OxfordUniRacing/TSAL_ECAD/doc/Compensation_Design.png

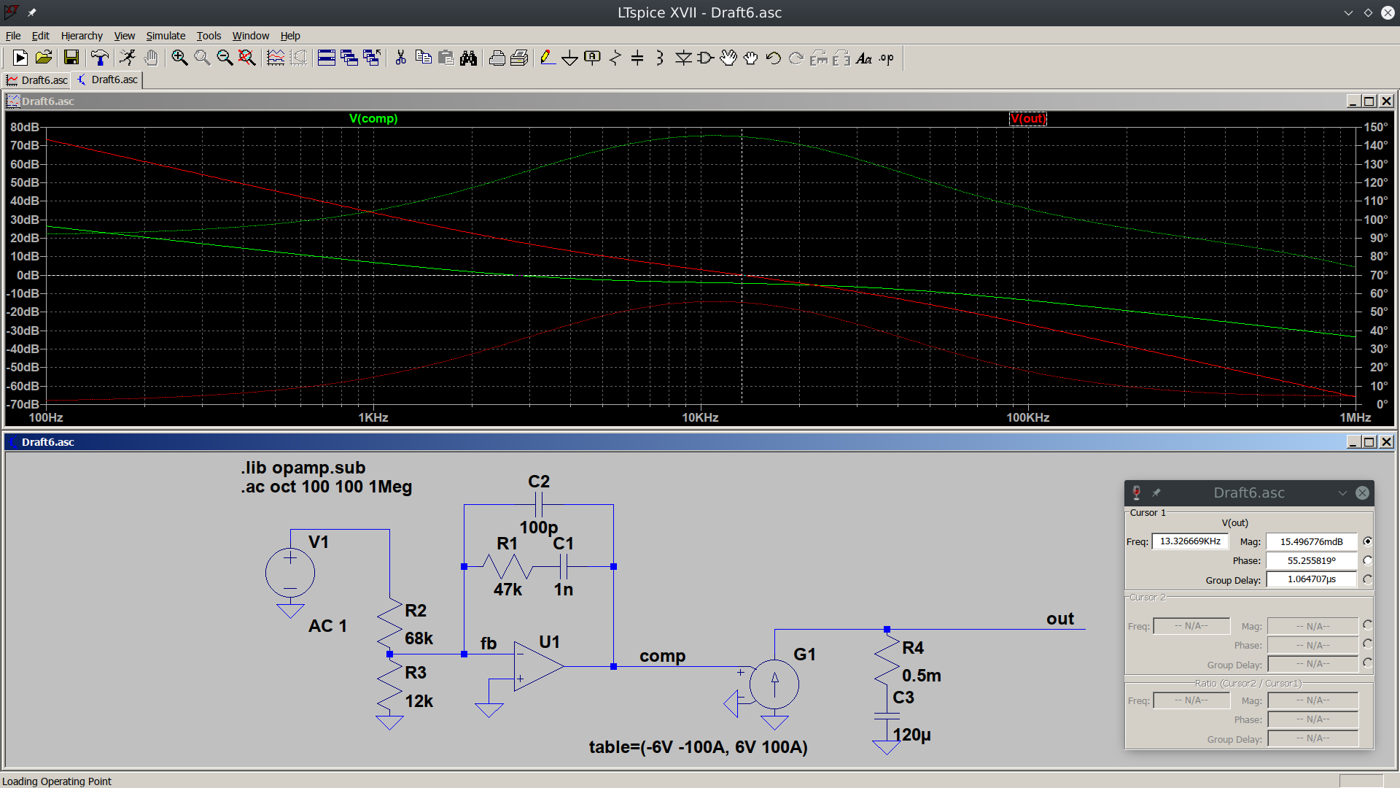
doc/Compensation_Design.png
