OxfordUniRacing/TSAL_ECAD/3d/Molex_Micro-Fit_3.0_43045-0412_2x02_P3.00mm_Vertical.step

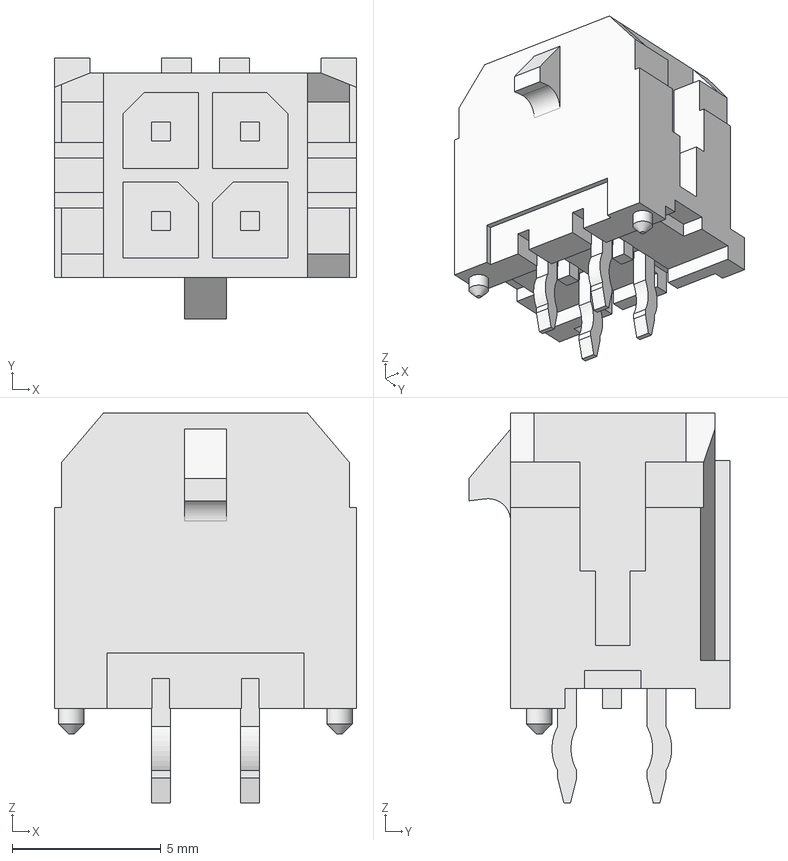
[picture p2: CAD file, 2021-02-28]
3d/Molex_Micro-Fit_3.0_43045-0412_2x02_P3.00mm_Vertical.step
10.2 x 8.77 x 13.1 mm
