OxfordUniRacing/TSAL_ECAD/LED/TSAL_LED.step

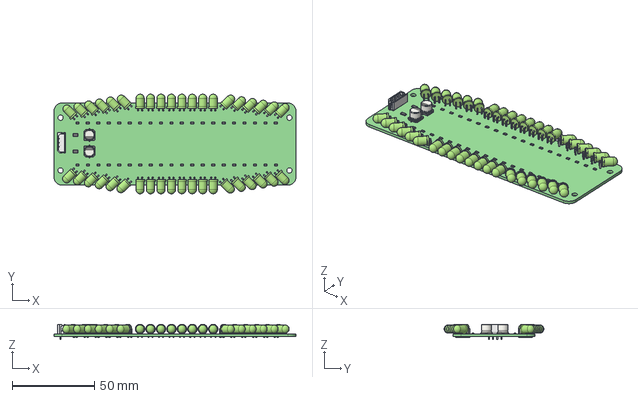
[picture p3: CAD file, 2021-11-17]
LED/TSAL_LED.step
147.0 x 60.6 x 9.40 mm
