OxfordUniRacing/TSAL_ECAD/3d/Molex_Nano-Fit_105309-xx02_1x02_P2.50mm_Vertical.step

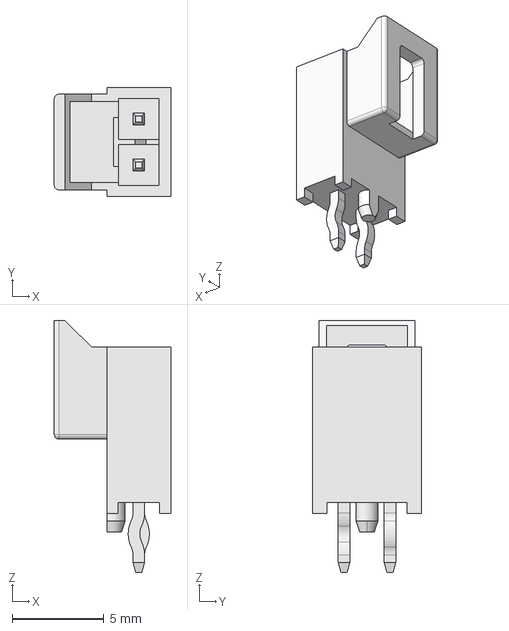
[picture p4: CAD file, 2020-02-12]
3d/Molex_Nano-Fit_105309-xx02_1x02_P2.50mm_Vertical.step
6.34 x 5.94 x 13.7 mm
