OxfordUniRacing/TSAL_ECAD/3d/Molex_SPOX_5267-06A_1x06_P2.50mm_Vertical.step

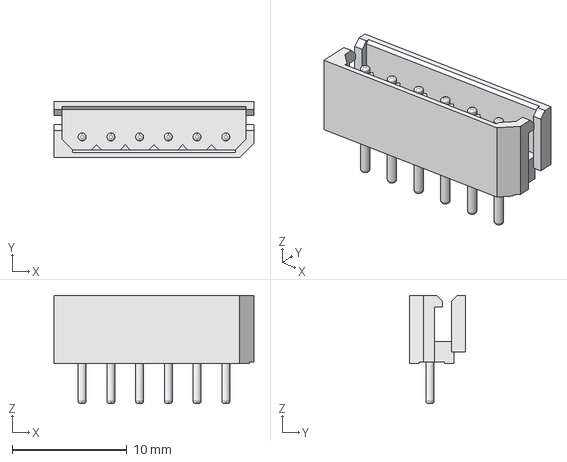
[picture p5: CAD file, 2019-12-10]
3d/Molex_SPOX_5267-06A_1x06_P2.50mm_Vertical.step
17.4 x 4.90 x 9.40 mm
