OxfordUniRacing/TSAL_ECAD/3d/Molex_Mini-Fit_Jr_5566-02A_2x01_P4.20mm_Vertical.step

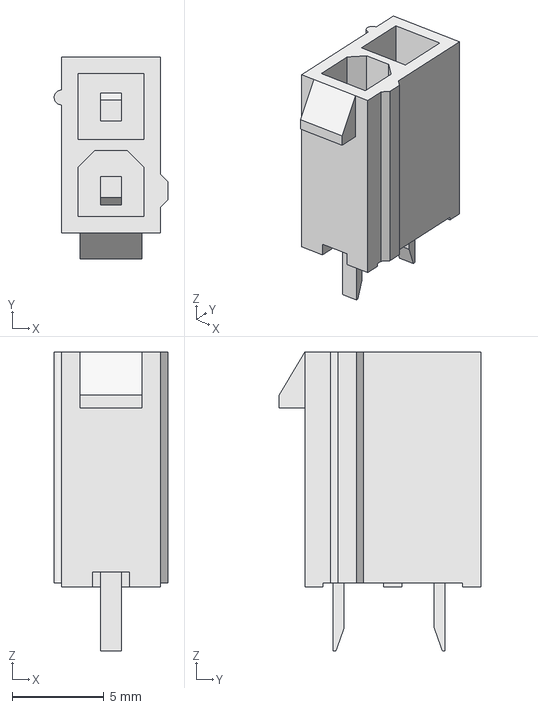
[picture p6: CAD file, 2019-12-10]
3d/Molex_Mini-Fit_Jr_5566-02A_2x01_P4.20mm_Vertical.step
6.20 x 11.0 x 16.3 mm
