OxfordUniRacing/TSAL_ECAD/3d/Molex_SPOX_5267-04A_1x04_P2.50mm_Vertical.step

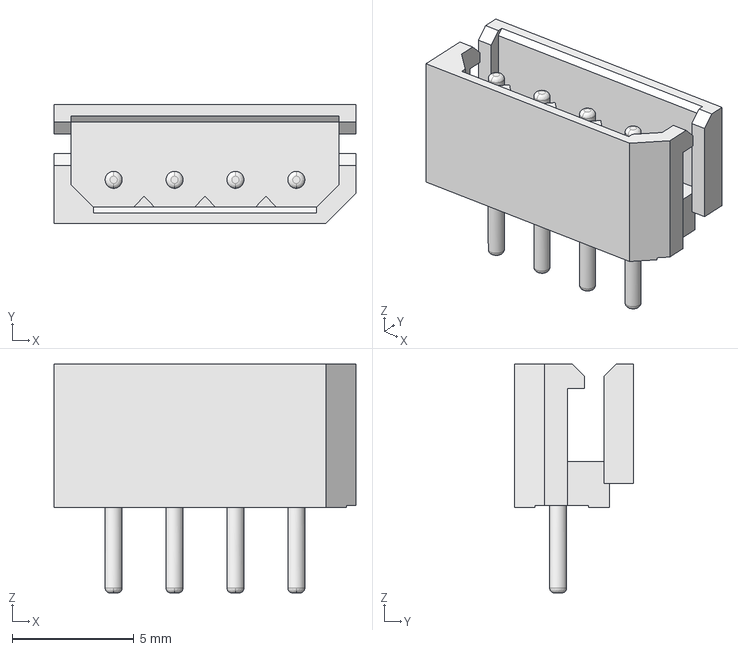
[picture p7: CAD file, 2019-12-10]
3d/Molex_SPOX_5267-04A_1x04_P2.50mm_Vertical.step
12.4 x 4.90 x 9.40 mm
