OxfordUniRacing/TSAL_ECAD/3d/Molex_SPOX_5267-02A_1x02_P2.50mm_Vertical.step

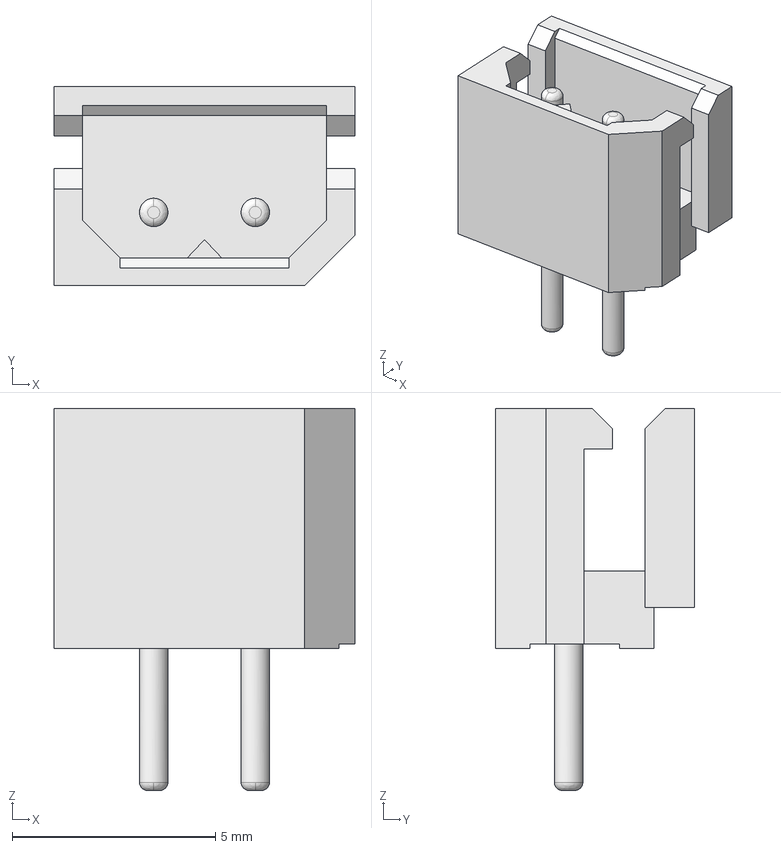
[picture p8: CAD file, 2019-12-10]
3d/Molex_SPOX_5267-02A_1x02_P2.50mm_Vertical.step
7.40 x 4.90 x 9.40 mm
