OxfordUniRacing/TSAL_ECAD/3d/Molex_SPOX_5267-03A_1x03_P2.50mm_Vertical.step

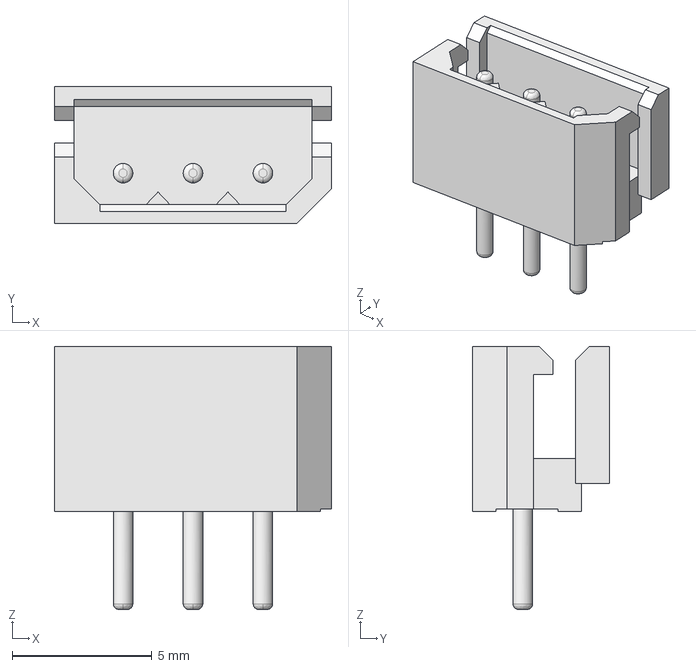
[picture p9: CAD file, 2019-12-10]
3d/Molex_SPOX_5267-03A_1x03_P2.50mm_Vertical.step
9.90 x 4.90 x 9.40 mm
