OxfordUniRacing/TSAL_ECAD/3d/TPS63020.step

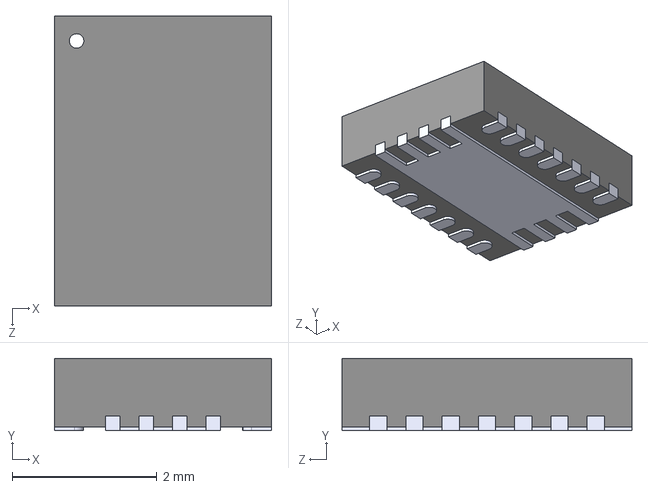
[picture p10: CAD file, 2021-02-22]
3d/TPS63020.step
3.00 x 1.00 x 4.00 mm
