OxfordUniRacing/TSAL_ECAD/Main/schematics.pdf

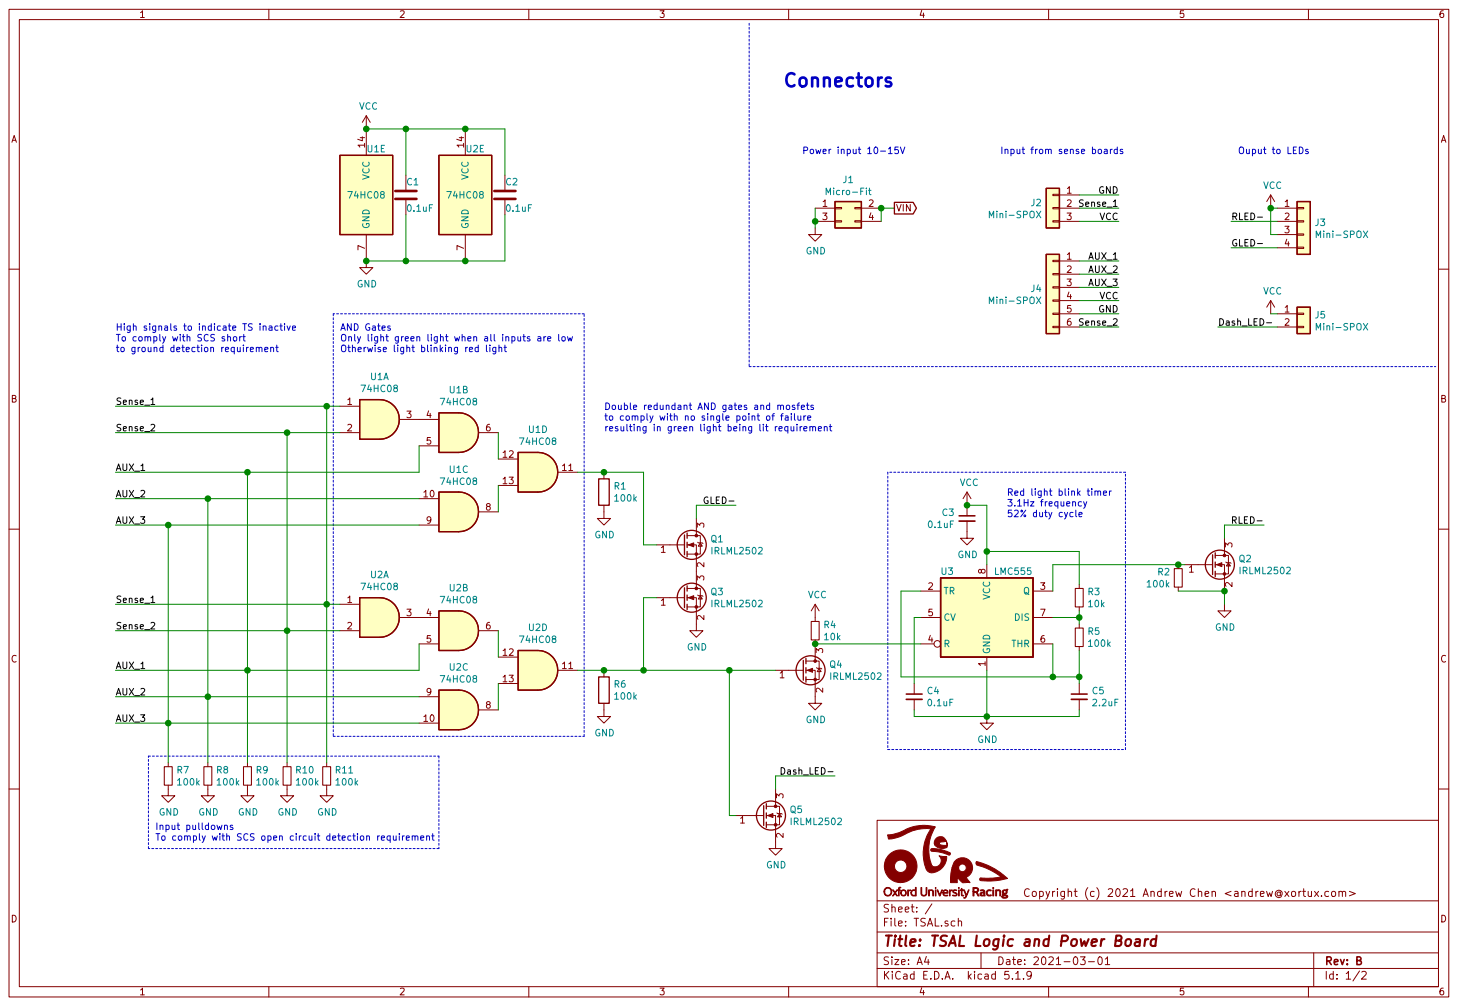
[picture p11: page 1]

Sheet: Power File: TSAL_Power.sch C1

Input from sense boards

High signals to indicate TS inactive
To comply with SCS short

Otherwise light blinking red light

Double redundant AND gates and mosfets
to comply with no single point of failure
resulting in green light being lit requirement

Input pulldowns
To comply with SCS open circuit detection requirement

Id: 1/2 Title: TSAL Logic and Power Board

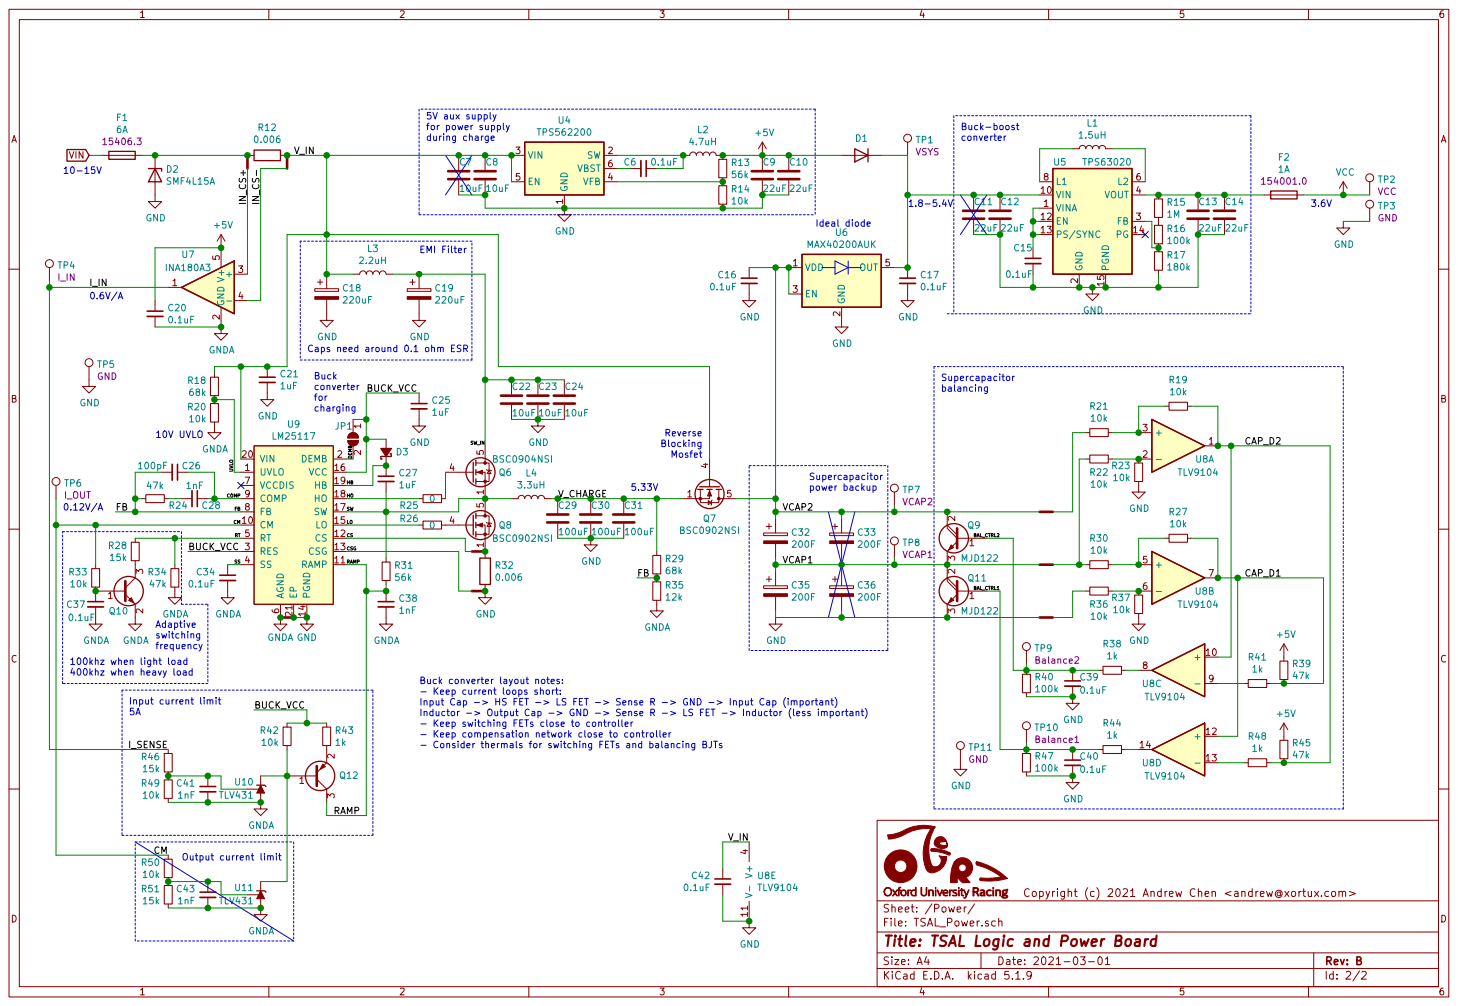
[picture p12: page 2]

FB COMP UVLO RT IN_CS+

1 SW 2 VIN 3 VFB 4 EN 5 VBST 6 U4 TPS562200 L2

Caps need around 0.1 ohm ESR

I_OUT
- Consider thermals for switching FETs and balancing BJTs 0.12V/A

Buck converter layout notes:
- Keep current loops short:
Input Cap -> HS FET -> LS FET -> Sense R -> GND -> Input Cap (important)
Inductor -> Output Cap -> GND -> Sense R -> LS FET -> Inductor (less important)
- Keep switching FETs close to controller
- Keep compensation network close to controller

Id: 2/2 Title: TSAL Logic and Power Board
