OxfordUniRacing/TSAL_ECAD/Main/TSAL.kicad_pcb

## KiCad design Main/TSAL.kicad_pcb (2022-04-25)

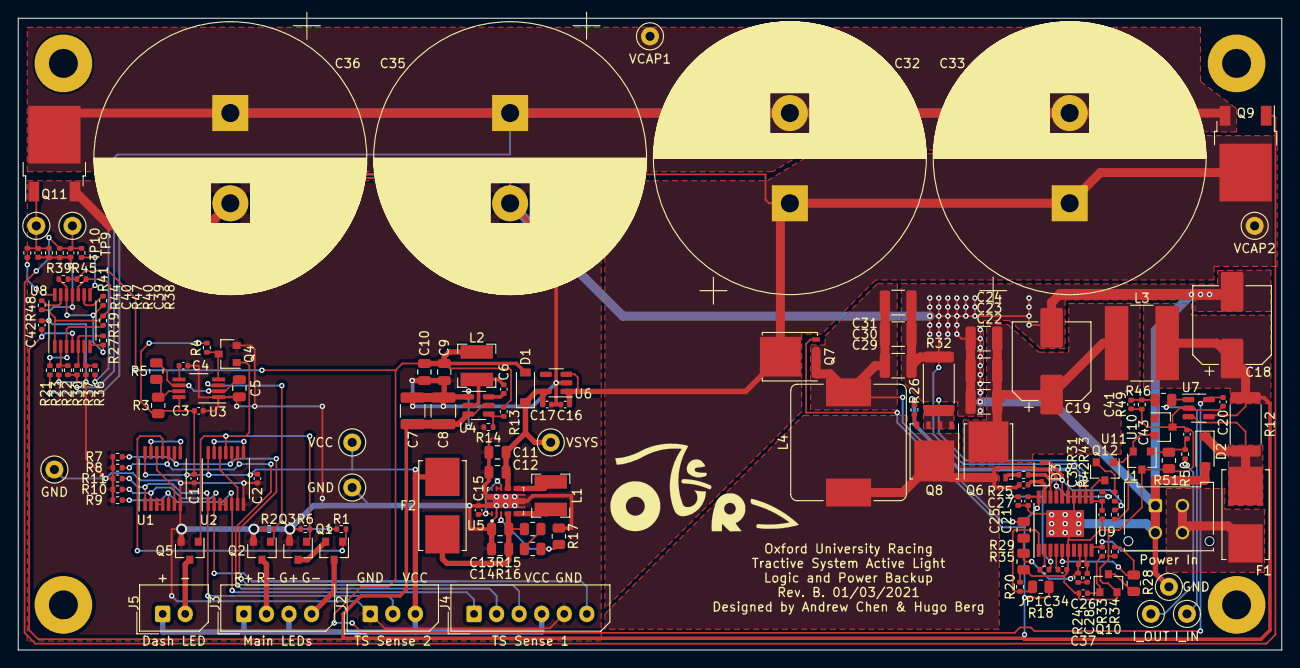
[picture p13: board TSAL.kicad_pcb from above]

Board: 2 copper layers, 140.0 x 70.0 mm, 155 parts (1 on the bottom side), 86 nets.

Parts:
C1, C2, C3, C4, C6, C15, C16, C17, C20, C34, C37, C39, C40, C42: 0.1uF; C_0402_1005Metric
C5: 2.2uF; C_0805_2012Metric
C7, C8, C22, C23, C24: 10uF; C_1210_3225Metric
C9, C10, C11, C12, C13, C14: 22uF; C_0805_2012Metric
C18, C19: 220uF; CP_Elec_8x10.5
C21, C25, C27: 1uF; C_0402_1005Metric
C26: 100pF; C_0402_1005Metric
C28, C38, C41, C43: 1nF; C_0402_1005Metric
C29, C30, C31: 100uF; C_1210_3225Metric
C32, C33, C35, C36: 200F; CP_Radial_D30.0mm_P10.00mm_SnapIn
D1: D_SOD-123
D2: SMF4L15A; D_SOD-123
D3: D_SOD-323
F1: 6A; Fuseholder_Littelfuse_Nano2_154x
F2: 1A; Fuseholder_Littelfuse_Nano2_154x
H1, H2, H3, H4: MountingHole; MountingHole_3.2mm_M3_Pad
J1: Micro-Fit; Molex_Micro-Fit_3.0_43045-0412_2x02_P3.00mm_Vertical
J2: Mini-SPOX; Molex_SPOX_5267-03A_1x03_P2.50mm_Vertical
J3: Mini-SPOX; Molex_SPOX_5267-04A_1x04_P2.50mm_Vertical
J4: Mini-SPOX; Molex_SPOX_5267-06A_1x06_P2.50mm_Vertical
J5: Mini-SPOX; Molex_SPOX_5267-02A_1x02_P2.50mm_Vertical
JP1: 0; R_0402_1005Metric
L1: 1.5uH; L_Bourns-SRN4018
L2: 4.7uH; L_Bourns-SRN4018
L3: 2.2uH; L_Bourns-SRN8040_8x8.15mm
L4: 3.3uH; L_Bourns_SRP1245A
Q1, Q2, Q3, Q4, Q5: IRLML2502; SOT-23
Q6: BSC0904NSI; TDSON-8-1
Q7, Q8: BSC0902NSI; TDSON-8-1
Q9, Q11: MJD122; TO-252-2
Q10: NPN; SOT-23
Q12: PNP; SOT-23
R1, R2, R6, R7, R8, R9, R10, R11, R40, R47: 100k; R_0402_1005Metric
R3: 10k; R_0805_2012Metric
R4, R14, R19, R20, R21, R22, R23, R27, R30, R33, R36, R37, R42, R49, R50: 10k; R_0402_1005Metric
R5, R16: 100k; R_0805_2012Metric
R12, R32: 0.006; R_2512_6332Metric
R13, R31: 56k; R_0402_1005Metric
R15: 1M; R_0805_2012Metric
R17: 180k; R_0805_2012Metric
R18, R29: 68k; R_0805_2012Metric
R24, R34, R39, R45: 47k; R_0402_1005Metric
R25, R26: 0; R_0402_1005Metric
R28, R46, R51: 15k; R_0805_2012Metric
R35: 12k; R_0805_2012Metric
R38, R41, R43, R44, R48: 1k; R_0402_1005Metric
TP1, TP2, TP3, TP4, TP5, TP6, TP7, TP8, TP9, TP10, TP11: TestPoint_Loop_D2.50mm_Drill1.0mm
U1, U2: 74HC08; TSSOP-14_4.4x5mm_P0.65mm
U3: LMC555; VSSOP-8_3.0x3.0mm_P0.65mm
U4: TPS562200; SOT-23-6
U5: TPS63020
U6: MAX40200AUK; SOT-23-5
U7: INA180A3; SOT-23-5
U8: TLV9104; TSSOP-14_4.4x5mm_P0.65mm
U9: LM25117; ETSSOP-20-1EP_4.4x6.5mm_P0.65mm_EP3x4.2mm
U10, U11: TLV431; SOT-23
ZZ1, ZZ2, ZZ3, ZZ4, ZZ5, ZZ6, ZZ7, ZZ8: Trace_0.2mmx0.6mm

Connections:
+5V: C9.1, C10.1, C20.1, D1.2, L2.2, R13.1, R39.2, R45.2, U7.5
/AUX_1: J4.1, R9.1, U1.5, U2.5
/AUX_2: J4.2, R8.1, U1.10, U2.9
/AUX_3: J4.3, R7.1, U1.9, U2.10
/Dash_LED-: J5.2, Q5.3
/GLED-: J3.4, Q1.3
/Power/BAL_CTRL1: C40.1, Q11.1, R44.1, R47.2, TP10.1
/Power/BAL_CTRL2: C39.1, Q9.1, R38.1, R40.2, TP9.1
/Power/BUCK_VCC: C25.1, D3.2, JP1.1, R42.1, R43.1, U9.3, U9.16
/Power/CAP_D1: R27.2, R39.1, R41.2, U8.7, U8.12
/Power/CAP_D2: R19.2, R45.1, R48.2, U8.1, U8.10
/Power/CM: R33.1, R50.1, TP6.1, U9.10
/Power/COMP: C26.1, C28.1, U9.9
/Power/CS: U9.12, ZZ4.1
/Power/CSG: U9.13, ZZ6.1
/Power/DEMB: JP1.2, U9.2
/Power/FB: C26.2, R24.2, R29.2, R35.1, U9.8
/Power/HB: C27.1, D3.1, U9.19
/Power/HO: R25.2, U9.18
/Power/IN_CS+: U7.3, ZZ1.1
/Power/IN_CS-: U7.4, ZZ2.1
/Power/I_IN: R46.1, TP4.1, U7.1
/Power/LO: R26.2, U9.15
/Power/RAMP: C38.1, Q12.3, R31.2, U9.11
/Power/RT: R28.1, R34.1, U9.5
/Power/SS: C34.1, U9.4
/Power/SW: C27.2, L4.1, Q6.1, Q6.2, Q6.3, Q8.5, R31.1, U9.17
/Power/SW_IN: C19.1, C22.1, C23.1, C24.1, L3.2, Q6.5
/Power/UVLO: R18.2, R20.1, U9.1
/Power/VCAP1: C32.2, C33.2, C35.1, C36.1, Q9.3, Q11.2, TP8.1, ZZ5.1
/Power/VCAP2: C16.1, C32.1, C33.1, Q7.5, Q9.2, TP7.1, U6.1, U6.3, ZZ3.1
/Power/V_CHARGE: C29.1, C30.1, C31.1, L4.2, Q7.1, Q7.2, Q7.3, R29.1
/Power/V_IN: C7.1, C8.1, C18.1, C21.1, C42.1, L3.1, Q7.4, R12.2, R18.1, U4.3, U4.5, U8.4, U9.20, ZZ2.2
/RLED-: J3.2, Q2.3
/Sense_1: J2.2, R11.1, U1.1, U2.1
/Sense_2: J4.6, R10.1, U1.2, U2.2
GND: C1.2, C2.2, C3.2, C4.2, C5.2, C7.2, C8.2, C9.2, C10.2, C11.2, C12.2, C13.2, C14.2, C15.2, C16.2, C17.2, C18.2, C19.2, C21.2, C22.2, C23.2, C24.2, C25.2, C29.2, C30.2, C31.2, C35.2, C36.2, C39.2, C40.2, C42.2, D2.2, J1.1, J1.3, J2.1, J4.5, Q2.2, Q3.2, Q4.2, Q5.2, Q11.3, R1.2, R2.2, R6.2, R7.2, R8.2, R9.2, R10.2, R11.2, R14.2, R17.2, R23.1, R32.2, R37.1, R40.1, R47.1, TP3.1, TP5.1, TP11.1, U1.7, U2.7, U3.1, U4.1, U5.2, U5.15, U6.2, U8.11, U9.14, U9.21, ZZ6.2, ZZ7.2, ZZ8.1
GNDA: C20.2, C34.2, C37.2, C38.2, C41.2, C43.2, Q10.2, R20.2, R34.2, R35.2, R49.2, R51.2, U7.2, U9.6, U10.3, U11.3, ZZ7.1
unnamed: C4.1, U3.5
unnamed: C5.1, R5.2, U3.2, U3.6
unnamed: C6.1, L2.1, U4.2
unnamed: C6.2, U4.6
unnamed: C11.1, C12.1, C17.1, D1.1, TP1.1, U5.10, U5.11, U6.5
unnamed: C13.1, C14.1, F2.2, R15.1, U5.4, U5.5
unnamed: C15.1, U5.1, U5.12, U5.13
unnamed: C28.2, R24.1
unnamed: C37.1, Q10.1, R33.2
unnamed: C41.1, R46.2, R49.1, U10.1
unnamed: C43.1, R50.2, R51.1, U11.1
unnamed: D2.1, F1.1, R12.1, ZZ1.2
unnamed: L1.1, U5.8, U5.9
unnamed: L1.2, U5.6, U5.7
unnamed: Q1.1, R1.1, U1.11
unnamed: Q1.2, Q3.3
unnamed: Q2.1, R2.1, U3.3
unnamed: Q3.1, Q4.1, Q5.1, R6.1, U2.11
unnamed: Q4.3, R4.2, U3.4
unnamed: Q6.4, R25.1
unnamed: Q8.1, Q8.2, Q8.3, R32.1, ZZ4.2
unnamed: Q8.4, R26.1
unnamed: Q10.3, R28.2
unnamed: Q12.1, R42.2, U10.2, U11.2
unnamed: Q12.2, R43.2
unnamed: R3.2, R5.1, U3.7
unnamed: R13.2, R14.1, U4.4
unnamed: R15.2, R16.1
unnamed: R16.2, R17.1, U5.3
unnamed: R19.1, R21.2, U8.3
unnamed: R21.1, ZZ3.2
unnamed: R22.1, R30.1, ZZ5.2
unnamed: R22.2, R23.2, U8.2
unnamed: R27.1, R30.2, U8.5
unnamed: R36.1, ZZ8.2
unnamed: R36.2, R37.2, U8.6
unnamed: R38.2, U8.8
unnamed: R41.1, U8.9
unnamed: R44.2, U8.14
unnamed: R48.1, U8.13
unnamed: U1.3, U1.4
unnamed: U1.6, U1.12
unnamed: U1.8, U1.13
unnamed: U2.3, U2.4
unnamed: U2.6, U2.12
unnamed: U2.8, U2.13
VCC: C1.1, C2.1, C3.1, F2.1, J2.3, J3.1, J3.3, J4.4, J5.1, R3.1, R4.1, TP2.1, U1.14, U2.14, U3.8
VIN: F1.2, J1.2, J1.4
