OxfordUniRacing/TSAL_ECAD/LED/TSAL_LED.kicad_pcb

## KiCad design LED/TSAL_LED.kicad_pcb (2022-04-25)

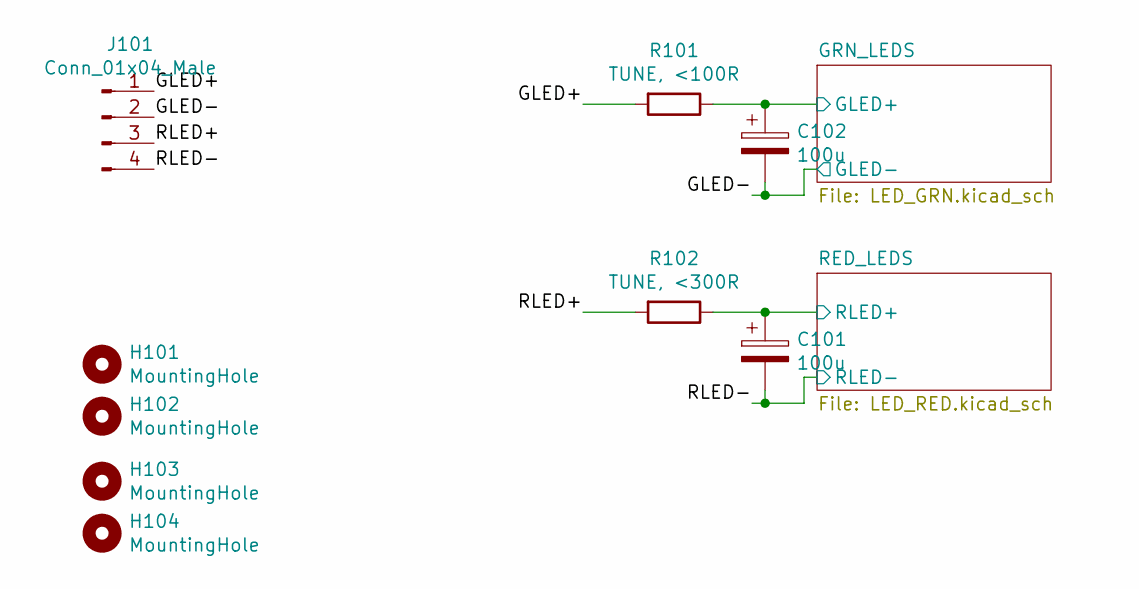
[picture p14: schematic TSAL_LED.kicad_sch]

Parts:
C101, C102: 100u; CP_Elec_6.3x5.8
H101, H102, H103, H104: MountingHole; MountingHole_3.2mm_M3_DIN965_Pad_TopBottom
J101: Conn_01x04_Male; Molex_SPOX_5267-04A_1x04_P2.50mm_Vertical
R101: TUNE, <100R; R_1206_3216Metric_Pad1.30x1.75mm_HandSolder
R102: TUNE, <300R; R_1206_3216Metric_Pad1.30x1.75mm_HandSolder

Connections:
/GLED+: J101.1, R101.2
/GLED-: C102.2, J101.2; also elsewhere on the board
/GRN_LEDS/GLED+: C102.1, R101.1; also elsewhere on the board
/RED_LEDS/RLED+: C101.1, R102.1; also elsewhere on the board
/RLED+: J101.3, R102.2
/RLED-: C101.2, J101.4; also elsewhere on the board

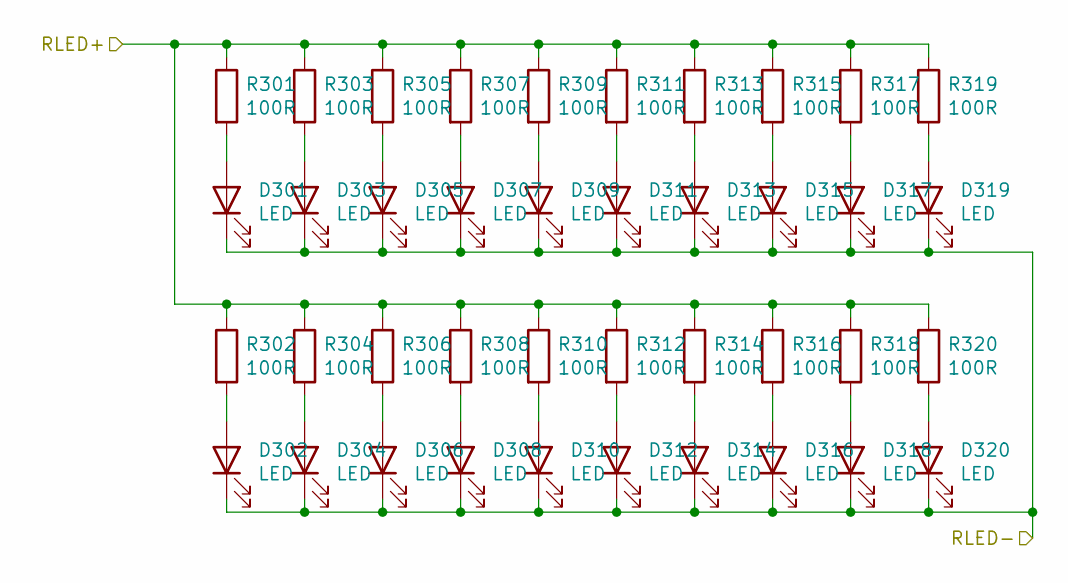
[picture p15: schematic LED_RED.kicad_sch]

Parts:
D301, D302, D303, D304, D305, D306, D307, D308, D309, D310, D311, D312, D313, D314, D315, D316, D317, D318, D319, D320: LED; LED_D5.0mm_Horizontal_O1.27mm_Z3.0mm
R301, R302, R303, R304, R305, R306, R307, R308, R309, R310, R311, R312, R313, R314, R315, R316, R317, R318, R319, R320: 100R; R_0805_2012Metric_Pad1.20x1.40mm_HandSolder

Connections:
/RED_LEDS/RLED+: R301.1, R302.1, R303.1, R304.1, R305.1, R306.1, R307.1, R308.1, R309.1, R310.1, R311.1, R312.1, R313.1, R314.1, R315.1, R316.1, R317.1, R318.1, R319.1, R320.1; also elsewhere on the board
/RLED-: D301.1 (K), D302.1 (K), D303.1 (K), D304.1 (K), D305.1 (K), D306.1 (K), D307.1 (K), D308.1 (K), D309.1 (K), D310.1 (K), D311.1 (K), D312.1 (K), D313.1 (K), D314.1 (K), D315.1 (K), D316.1 (K), D317.1 (K), D318.1 (K), D319.1 (K), D320.1 (K); also elsewhere on the board
unnamed: D301.2 (A), R301.2
unnamed: D302.2 (A), R302.2
unnamed: D303.2 (A), R303.2
unnamed: D304.2 (A), R304.2
unnamed: D305.2 (A), R305.2
unnamed: D306.2 (A), R306.2
unnamed: D307.2 (A), R307.2
unnamed: D308.2 (A), R308.2
unnamed: D309.2 (A), R309.2
unnamed: D310.2 (A), R310.2
unnamed: D311.2 (A), R311.2
unnamed: D312.2 (A), R312.2
unnamed: D313.2 (A), R313.2
unnamed: D314.2 (A), R314.2
unnamed: D315.2 (A), R315.2
unnamed: D316.2 (A), R316.2
unnamed: D317.2 (A), R317.2
unnamed: D318.2 (A), R318.2
unnamed: D319.2 (A), R319.2
unnamed: D320.2 (A), R320.2

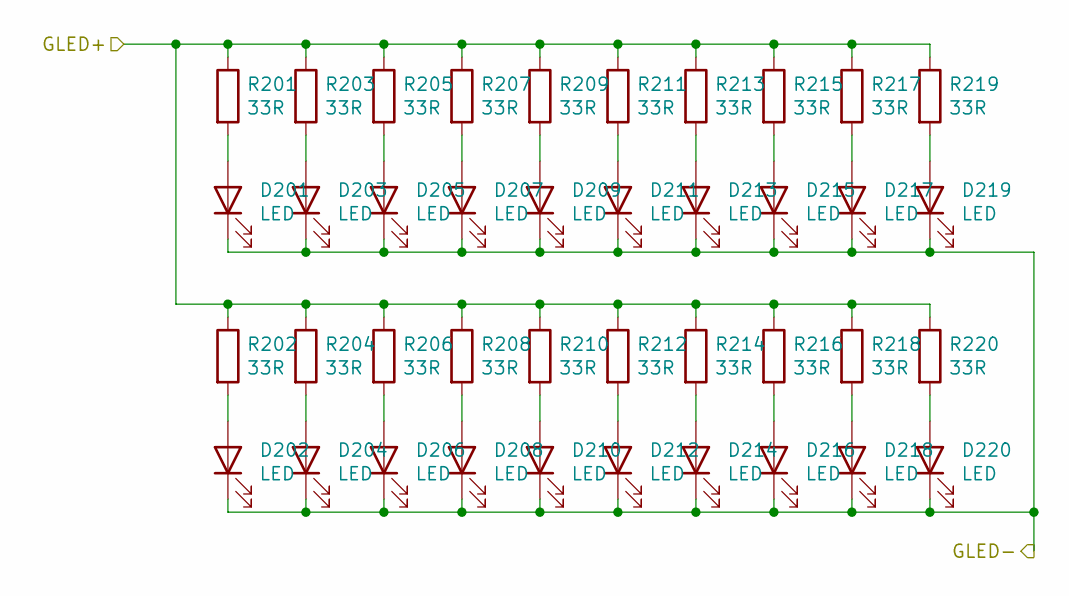
[picture p16: schematic LED_GRN.kicad_sch]

Parts:
D201, D202, D203, D204, D205, D206, D207, D208, D209, D210, D211, D212, D213, D214, D215, D216, D217, D218, D219, D220: LED; LED_D5.0mm_Horizontal_O1.27mm_Z3.0mm
R201, R202, R203, R204, R205, R206, R207, R208, R209, R210, R211, R212, R213, R214, R215, R216, R217, R218, R219, R220: 33R; R_0805_2012Metric_Pad1.20x1.40mm_HandSolder

Connections:
/GLED-: D201.1 (K), D202.1 (K), D203.1 (K), D204.1 (K), D205.1 (K), D206.1 (K), D207.1 (K), D208.1 (K), D209.1 (K), D210.1 (K), D211.1 (K), D212.1 (K), D213.1 (K), D214.1 (K), D215.1 (K), D216.1 (K), D217.1 (K), D218.1 (K), D219.1 (K), D220.1 (K); also elsewhere on the board
/GRN_LEDS/GLED+: R201.1, R202.1, R203.1, R204.1, R205.1, R206.1, R207.1, R208.1, R209.1, R210.1, R211.1, R212.1, R213.1, R214.1, R215.1, R216.1, R217.1, R218.1, R219.1, R220.1; also elsewhere on the board
unnamed: D201.2 (A), R201.2
unnamed: D202.2 (A), R202.2
unnamed: D203.2 (A), R203.2
unnamed: D204.2 (A), R204.2
unnamed: D205.2 (A), R205.2
unnamed: D206.2 (A), R206.2
unnamed: D207.2 (A), R207.2
unnamed: D208.2 (A), R208.2
unnamed: D209.2 (A), R209.2
unnamed: D210.2 (A), R210.2
unnamed: D211.2 (A), R211.2
unnamed: D212.2 (A), R212.2
unnamed: D213.2 (A), R213.2
unnamed: D214.2 (A), R214.2
unnamed: D215.2 (A), R215.2
unnamed: D216.2 (A), R216.2
unnamed: D217.2 (A), R217.2
unnamed: D218.2 (A), R218.2
unnamed: D219.2 (A), R219.2
unnamed: D220.2 (A), R220.2

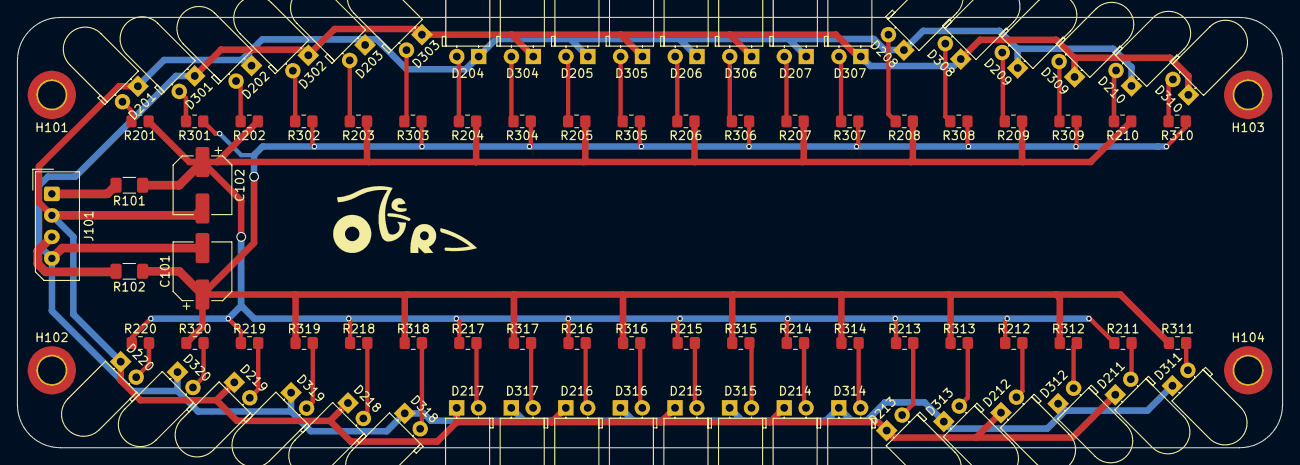
[picture p17: board TSAL_LED.kicad_pcb from above]

Board: 2 copper layers, 147.0 x 50.0 mm, 89 parts (0 on the bottom side), 46 nets.
