OxfordUniRacing/TSAL_ECAD/(commit log)

2019-12-10 initial import
    [Connectors.sch, Molex_Mini-Fit_Jr_5566-02A_2x01_P4.20mm_Vertical.step, Molex_SPOX_5267-02A_1x02_P2.50mm_Vertical.step, Molex_SPOX_5267-03A_1x03_P2.50mm_Vertical.step, Molex_SPOX_5267-04A_1x04_P2.50mm_Vertical.step, Molex_SPOX_5267-06A_1x06_P2.50mm_Vertical.step, TSAL.kicad_pcb, TSAL.sch]
2020-01-18 change to ideal diode controller
    [TSAL.kicad_pcb, TSAL.sch, TSAL_Power.sch]
2020-01-27 last minute changes to test points and routing
    [TSAL.kicad_pcb, TSAL.sch, TSAL_Power.sch]
2020-01-27 Rev A gerbers
    [TSAL-B_Cu.gbr, TSAL-B_Mask.gbr, TSAL-B_SilkS.gbr, TSAL-Edge_Cuts.gbr, TSAL-F_Cu.gbr, TSAL-F_Mask.gbr, TSAL-F_SilkS.gbr, TSAL-NPTH.drl]
2020-02-09 added LED board
    [TSAL_LED.kicad_pcb, TSAL_LED.sch]
2020-02-09 remove boost converter for RLED
    [TSAL_LED.kicad_pcb, TSAL_LED.sch]
2020-02-10 Redo HV sense boards
    - added circuitry & connector for ts active led
    - added led indicators for relay aux
    [Molex_Nano-Fit_105309-xx02_1x02_P2.50mm_Vertical.step, TSAL_HV_Sense.kicad_pcb, TSAL_HV_Sense.sch]
2020-02-10 hv sense: include mechanical info in schematics
    [TSAL_HV_Sense.sch]
2020-02-12 shuffled some files around, generated gerbers
    [TSAL-B_Cu.gbr, TSAL-B_Mask.gbr, TSAL-B_SilkS.gbr, TSAL-Edge_Cuts.gbr, TSAL-F_Cu.gbr, TSAL-F_Mask.gbr, TSAL-F_SilkS.gbr, TSAL-NPTH.drl]
2020-02-19 tsal sense board update
    hopefully last update
    [TSAL.sch, TSAL_HV_Sense.kicad_pcb, TSAL_HV_Sense.sch]
2020-02-19 use outline layer for cutout
    [TSAL_HV_Sense.kicad_pcb]
2020-02-19 oops obsolete part
    [TSAL_HV_Sense.kicad_pcb, TSAL_HV_Sense.sch]
2021-02-07 re-organize files
    [TSAL-B_Cu.gbr, TSAL-B_Mask.gbr, TSAL-B_SilkS.gbr, TSAL-Edge_Cuts.gbr, TSAL-F_Cu.gbr, TSAL-F_Mask.gbr, TSAL-F_SilkS.gbr, TSAL-NPTH.drl]
2021-02-10 Added new design of TSAL LED board
    [LED_COLOR.sch, LED_GRN.sch, LED_RED.sch, TSAL_LED_V2.kicad_pcb, TSAL_LED_V2.sch]
2021-02-18 HV_Sense: change hv input connector to Micro-Fit
    [TSAL_HV_Sense.kicad_pcb, TSAL_HV_Sense.sch]
2021-02-18 HV_Sense: update schematics
    [TSAL_HV_Sense.kicad_pcb, TSAL_HV_Sense.sch]
2021-02-22 Main board: Rev B schematics design
    major redesign of power delivery and backup
    [TPS63020.step, TSAL.kicad_pcb, TSAL.sch, TSAL_Power.sch]
2021-02-22 Main board; tweak feedback compensation network
    [TSAL_Power.sch]
2021-02-23 Main board: final change to compensation network
    None of this really matters with the supercaps at the output,
    just trying to optimize the loop without them.
    [TSAL.sch, TSAL_Power.sch]
2021-02-23 Move LED board files
    [LED_COLOR.sch, LED_GRN.sch, LED_RED.sch, TSAL_LED.kicad_pcb, TSAL_LED.sch, TSAL_LED_V2.kicad_pcb, TSAL_LED_V2.sch]
2021-02-24 Added first rev of design of new TSAL main board
    [TSAL.kicad_pcb, TSAL_Power.sch]
2021-02-25 LED board: fix connector 3d model
    [TSAL_LED.kicad_pcb]
2021-02-28 Main: optimized layout
    [Molex_Micro-Fit_3.0_43045-0412_2x02_P3.00mm_Vertical.step, TSAL.kicad_pcb, TSAL.sch, TSAL_Power.sch]
2021-02-28 Main: fix rescue symbols
    [TSAL_Power.sch]
2021-03-01 Main: update sot23-5/6 footprints
    Bloody kicad libaries
    [TSAL.kicad_pcb, TSAL_Power.sch]
2021-03-01 Main: archive symbols and footprints
    Kicad library management is really terrible.
    This is pulled together with janky scripts and sed.
    [TSAL.kicad_pcb, TSAL.sch, TSAL_Power.sch]
2021-03-01 Main board rev b release?
    [TSAL-B_Cu.gbr, TSAL-B_Mask.gbr, TSAL-B_SilkS.gbr, TSAL-Dwgs_User.gbr, TSAL-Edge_Cuts.gbr, TSAL-F_Cu.gbr, TSAL-F_Mask.gbr, TSAL-F_SilkS.gbr]
2021-03-01 kicad please I wanted solid gnd connections
    [TSAL-B_Cu.gbr, TSAL-B_Mask.gbr, TSAL-B_SilkS.gbr, TSAL-Dwgs_User.gbr, TSAL-Edge_Cuts.gbr, TSAL-F_Cu.gbr, TSAL-F_Mask.gbr, TSAL-F_SilkS.gbr]
2021-03-08 increase output filter capacitor value
    [TSAL.kicad_pcb, TSAL_Power.sch]
2021-06-01 Fixed LMC555 footprint error on main TSAL board
    [TSAL.kicad_pcb, TSAL.sch]
2021-11-17 Updated to version that was ordered
    [TSAL.kicad_pcb, TSAL_LED.kicad_pcb, TSAL_LED.step]
2022-04-25 hv sense v2
    [LED_GRN.kicad_sch, LED_RED.kicad_sch, TSAL.kicad_pcb, TSAL.kicad_sch, TSAL_HV_Sense.kicad_pcb, TSAL_HV_Sense.sch, TSAL_LED.kicad_pcb, TSAL_LED.kicad_sch]
