OxfordUniRacing/TSAL_ECAD/(notices)

Notices in the files:
Main/TSAL_Power.sch:
Copyright (c) 2021 Andrew Chen
